spiricom/Genera_Experimenter/README.md

# Vocodec repository
Repository of code for the Snyderphonics Vocodec vocal processor unit.
requires LEAF as a submodule.
