spiricom/Genera_Experimenter/kicad_files/H7Experimenternew/STM32H7_experimenter/Genera_Experimenter_rev1_README.rtf

README.txt for Genera_Experimenter_rev1

Designer : Jeff Snyder

4-layer PCB
1oz copper
matte black soldermask
2.4625" X 3.3750" board size
Not ITAR controlled

smallest drill 10 mils
smallest trace 8 mils
smallest space 8 mils
silkscreen on top and bottom

file extensions:
.cmp = top copper
.ly2 = layer 2 copper
.ly3 = layer 3 copper
.sol = bottom copper
.stc = stopmask top
.sts = stopmask bottom
.plc = silkscreen top
.pls = silkscreen bottom
.drd = excellon drill file
.mil = outline milling
.crc = solder paste top
.crs = solder paste bottom
