spiricom/Genera_Experimenter/kicad_files/H7Experimenternew/stm32H7_experimenter10.brd

## EAGLE design kicad_files/H7Experimenternew/stm32H7_experimenter10.brd (2026-07-16)

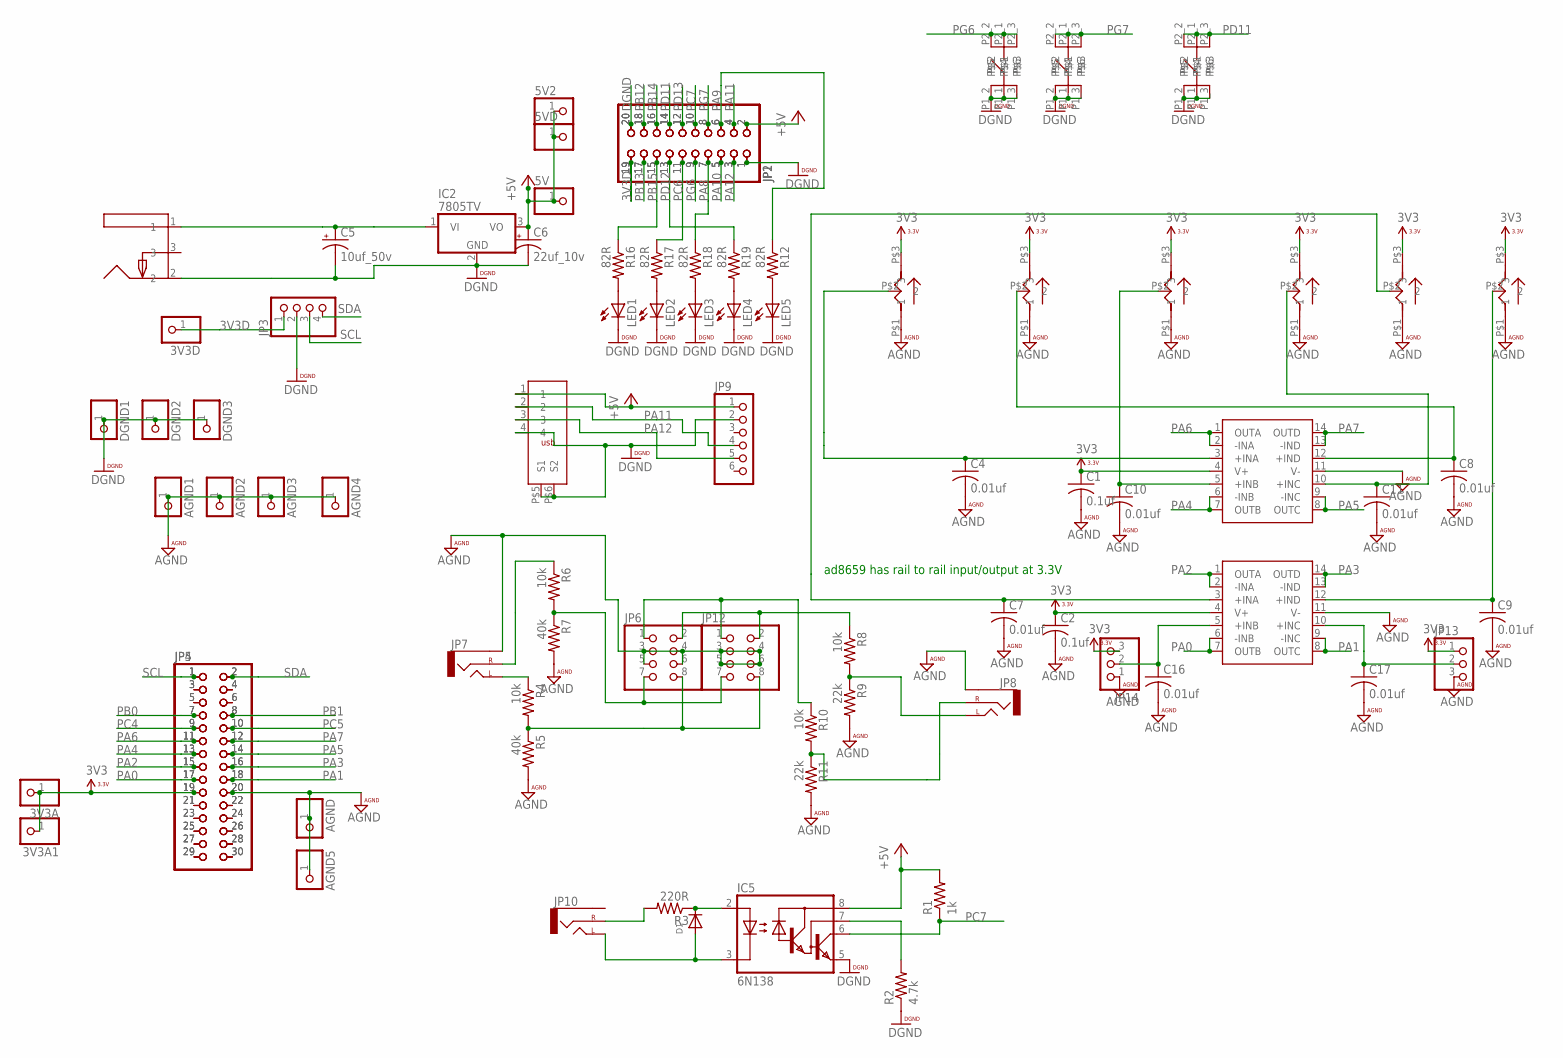
[picture p4: schematic stm32H7_experimenter10.sch]

Parts:
3V3A, 3V3A1, 3V3D, 5V, 5V2, 5VD: PINHD-1X1; 1X01; PARTNO *DNP
AGND, AGND1, AGND2, AGND3, AGND4, AGND5: PINHD-1X1; 1X01; PARTNO *DNP
C1, C2: 0.1uf; C025-030X050; PARTNO K104K15X7RF5TL2
C4, C7, C8, C9, C10, C11, C16, C17: 0.01uf; C025-030X050; PARTNO K103K15X7RF5TL2
C5: 10uf_50v; SMC_C; PARTNO 293D106X9035C2TE3
C6: 22uf_10v; SMC_C; PARTNO T491C226K016AT
D1: DIODEDO-1N4148; DO-1N4148; PARTNO 1N4148
DGND1, DGND2, DGND3: PINHD-1X1; 1X01; PARTNO *DNP
IC1, IC3: AD8659; SO14; PARTNO AD8659ARZ-R7
IC2: 7805TV; TO220V; PARTNO VX7805-1000
IC5: 6N138; DIL08; PARTNO 6N138
JP1: PINHD-2X10; 2X10; PARTNO *DNP
JP2: PINHD-2X10; 2X10; PARTNO 67996-120HLF
JP3: PINHD-1X4; 1X04; PARTNO *DNP
JP4: PINHD-2X15; 2X15; PARTNO 67996-130HLF
JP5: PINHD-2X15; 2X15; PARTNO *DNP
JP6: PINHD-2X4; 2X04; PARTNO 67996-108HLF
JP7, JP8, JP10: AUDIO-JACKPTH; AUDIO-JACK; PARTNO SJ1-3525N
JP9: PINHD-1X6; 1X06
JP12: PINHD-2X4; 2X04; PARTNO *DNP
JP13, JP14: PINHD-1X3; 1X03; PARTNO *DNP
LED1, LED2, LED3, LED4, LED5: LED3MM; PARTNO 151031SS04000
P1, P2, P3, P4, P5, P6: RK09SONGHUEI; R0904N; PARTNO *
R1: 1k; 0204/5; PARTNO RNMF14FTC1K00
R2: 4.7k; 0204/5; PARTNO RNMF14FTC4K70
R3: 220R; 0204/5; PARTNO RNMF14FTC220R
R4, R6, R8, R10: 10k; 0204/5; PARTNO RNMF14FTC10K0
R5, R7: 40k; 0204/5; PARTNO RNMF14FTC39K0
R9, R11: 22k; 0204/5; PARTNO RNMF14FTC22K0
R12, R18, R19: 82R; 0204/5; PARTNO RNMF14FTC82R0
R16, R17: 82R; 0204V; PARTNO RNMF14FTC82R0
S1, S2, S3: TL52_PLUS; PARTNO TL52AF160Q
U$1: PJ-058AH_PWR_JACK; PJ-058AH
U$3: USB_292303-1; 292303

Connections:
3V3A: 3V3A.1, 3V3A1.1, C1.1, C2.1, IC1.4 (V+), IC3.4 (V+), JP4.19, JP5.19, JP13.1, JP14.3, P1.P$3 (3), P2.P$3 (3), P3.P$3 (3), P4.P$3 (3), P5.P$3 (3), P6.P$3 (3)
3V3D: 3V3D.1, JP1.19, JP2.19, JP3.1
+5V: 5V.1, 5V2.1, 5VD.1, C6.+, IC2.3 (VO), IC5.8 (VCC), JP1.2, JP2.2, JP9.1, R1.2, U$3.1
AGND: AGND.1, AGND1.1, AGND2.1, AGND3.1, AGND4.1, AGND5.1, C1.2, C2.2, C4.2, C7.2, C8.2, C9.2, C10.2, C11.2, C16.2, C17.2, IC1.11 (V-), IC3.11 (V-), JP4.20, JP5.20, JP6.3, JP6.4, JP6.5, JP6.6, JP7.SLEEVE, JP8.SLEEVE, JP12.3, JP12.4, JP12.5, JP12.6, JP13.3, JP14.1, P1.P$1 (1), P2.P$1 (1), P3.P$1 (1), P4.P$1 (1), P5.P$1 (1), P6.P$1 (1), R5.2, R7.2, R9.2, R11.2
DGND: C5.-, C6.-, DGND1.1, DGND2.1, DGND3.1, IC2.2 (GND), IC5.5 (GND), JP1.1, JP1.20, JP2.1, JP2.20, JP3.2, JP9.2, LED1.K (C), LED2.K (C), LED3.K (C), LED4.K (C), LED5.K (C), R2.1, S1.P1_1, S1.P1_2, S1.P1_3, S2.P1_1, S2.P1_2, S2.P1_3, S3.P1_1, S3.P1_2, S3.P1_3, U$1.2, U$3.4, U$3.P$5 (S1), U$3.P$6 (S2)
unnamed: D1.A, IC5.3 (C), JP10.TIP (LEFT)
unnamed: D1.C, IC5.2 (A), R3.1
unnamed: IC5.7 (VB), R2.2
unnamed: JP10.RING (RIGHT), R3.2
unnamed: C4.1, IC1.3 (+INA), P1.P$2 (2)
unnamed: C8.1, IC1.12 (+IND), P2.P$2 (2)
unnamed: C10.1, IC1.5 (+INB), P3.P$2 (2)
unnamed: C11.1, IC1.10 (+INC), P4.P$2 (2)
unnamed: JP4.3, JP5.3
unnamed: JP4.4, JP5.4
unnamed: JP4.5, JP5.5
unnamed: JP4.6, JP5.6
unnamed: C7.1, IC3.3 (+INA), P5.P$2 (2)
unnamed: C9.1, IC3.12 (+IND), P6.P$2 (2)
unnamed: JP4.21, JP5.21
unnamed: JP4.22, JP5.22
unnamed: C5.+, IC2.1 (VI), U$1.1
unnamed: C16.1, IC3.5 (+INB), JP14.2
unnamed: JP6.8, JP12.8, R4.2, R5.1
unnamed: JP6.7, JP12.7, R6.2, R7.1
unnamed: LED5.A, R12.2
unnamed: JP7.TIP (LEFT), R4.1
unnamed: JP8.TIP (LEFT), R8.2, R9.1
unnamed: C17.1, IC3.10 (+INC), JP13.2
unnamed: JP7.RING (RIGHT), R6.1
unnamed: JP6.2, JP12.2, R8.1
unnamed: JP8.RING (RIGHT), R10.2, R11.1
unnamed: JP6.1, JP12.1, R10.1
unnamed: LED1.A, R16.2
unnamed: LED2.A, R17.2
unnamed: LED3.A, R18.2
unnamed: LED4.A, R19.2
unnamed: JP4.23, JP5.23
unnamed: JP4.24, JP5.24
unnamed: JP4.25, JP5.25
unnamed: JP4.26, JP5.26
unnamed: JP4.27, JP5.27
unnamed: JP4.28, JP5.28
unnamed: JP4.29, JP5.29
unnamed: JP4.30, JP5.30
PA0: IC3.6 (-INB), IC3.7 (OUTB), JP4.17, JP5.17
PA1: IC3.8 (OUTC), IC3.9 (-INC), JP4.18, JP5.18
PA2: IC3.1 (OUTA), IC3.2 (-INA), JP4.15, JP5.15
PA3: IC3.13 (-IND), IC3.14 (OUTD), JP4.16, JP5.16
PA4: IC1.6 (-INB), IC1.7 (OUTB), JP4.13, JP5.13
PA5: IC1.8 (OUTC), IC1.9 (-INC), JP4.14, JP5.14
PA6: IC1.1 (OUTA), IC1.2 (-INA), JP4.11, JP5.11
PA7: IC1.13 (-IND), IC1.14 (OUTD), JP4.12, JP5.12
PA8: JP1.7, JP2.7, R18.1
PA9: JP1.6, JP2.6, R12.1
PA10: JP1.5, JP2.5
PA11: JP1.4, JP2.4, JP9.4, U$3.2
PA12: JP1.3, JP2.3, JP9.5, U$3.3
PB0: JP4.7, JP5.7
PB1: JP4.8, JP5.8
PB12: JP1.18, JP2.18
PB13: JP1.17, JP2.17
PB14: JP1.16, JP2.16
PB15: JP1.15, JP2.15, R16.1
PC4: JP4.9, JP5.9
PC5: JP4.10, JP5.10
PC6: JP1.11, JP2.11, R17.1
PC7: IC5.6 (VO), JP1.10, JP2.10, R1.1
PD11: JP1.14, JP2.14, S3.P2_1, S3.P2_2, S3.P2_3
PD12: JP1.13, JP2.13, R19.1
PD13: JP1.12, JP2.12
PG6: JP1.9, JP2.9, S1.P2_1, S1.P2_2, S1.P2_3
PG7: JP1.8, JP2.8, S2.P2_1, S2.P2_2, S2.P2_3
SCL: JP3.3, JP4.1, JP5.1
SDA: JP3.4, JP4.2, JP5.2

Notes on the sheet:
ad8659 has rail to rail input/output at 3.3V

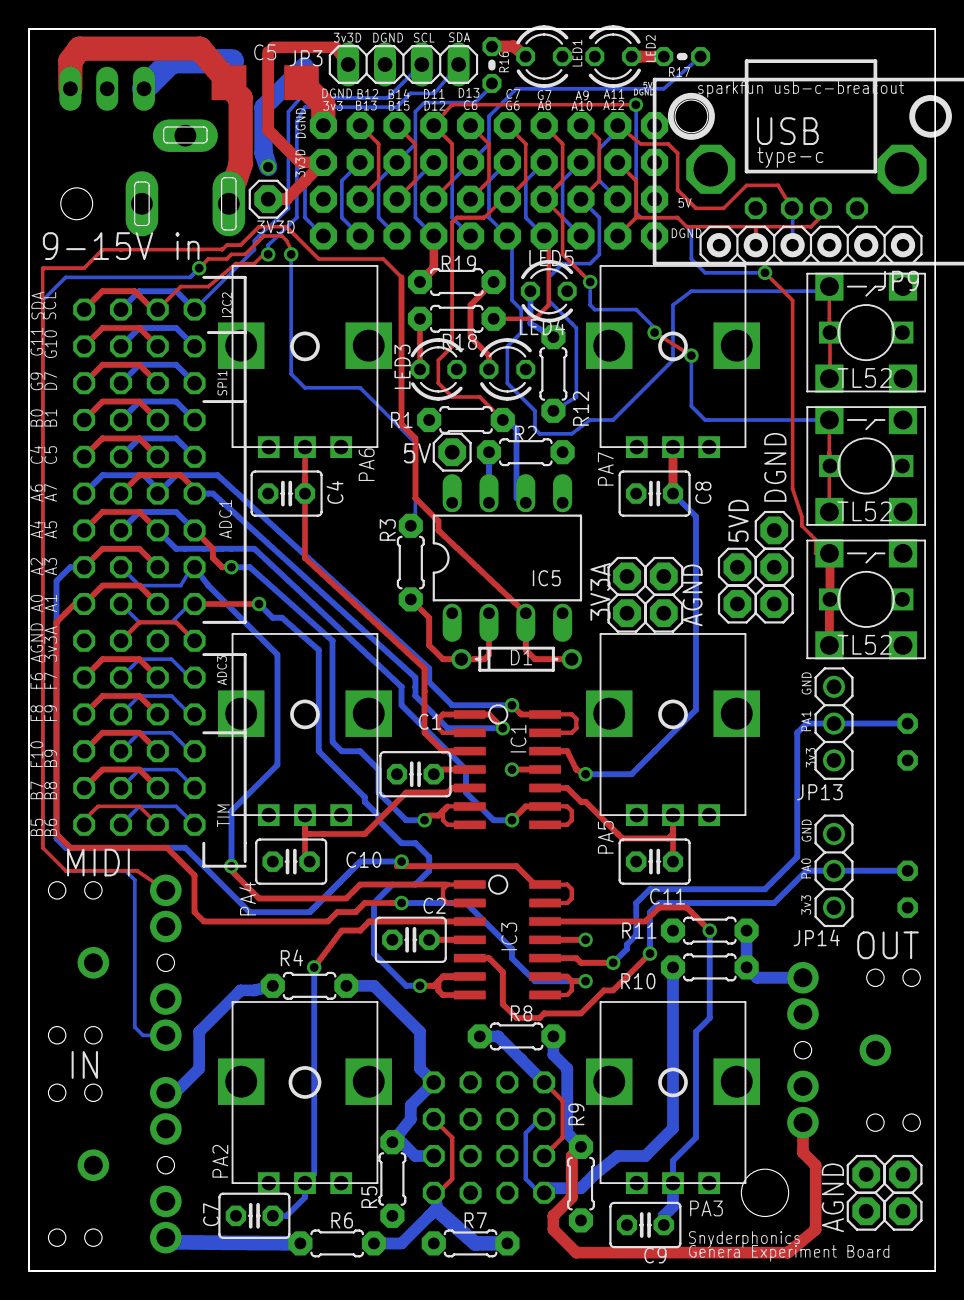
[picture p5: board stm32H7_experimenter10.brd from above]

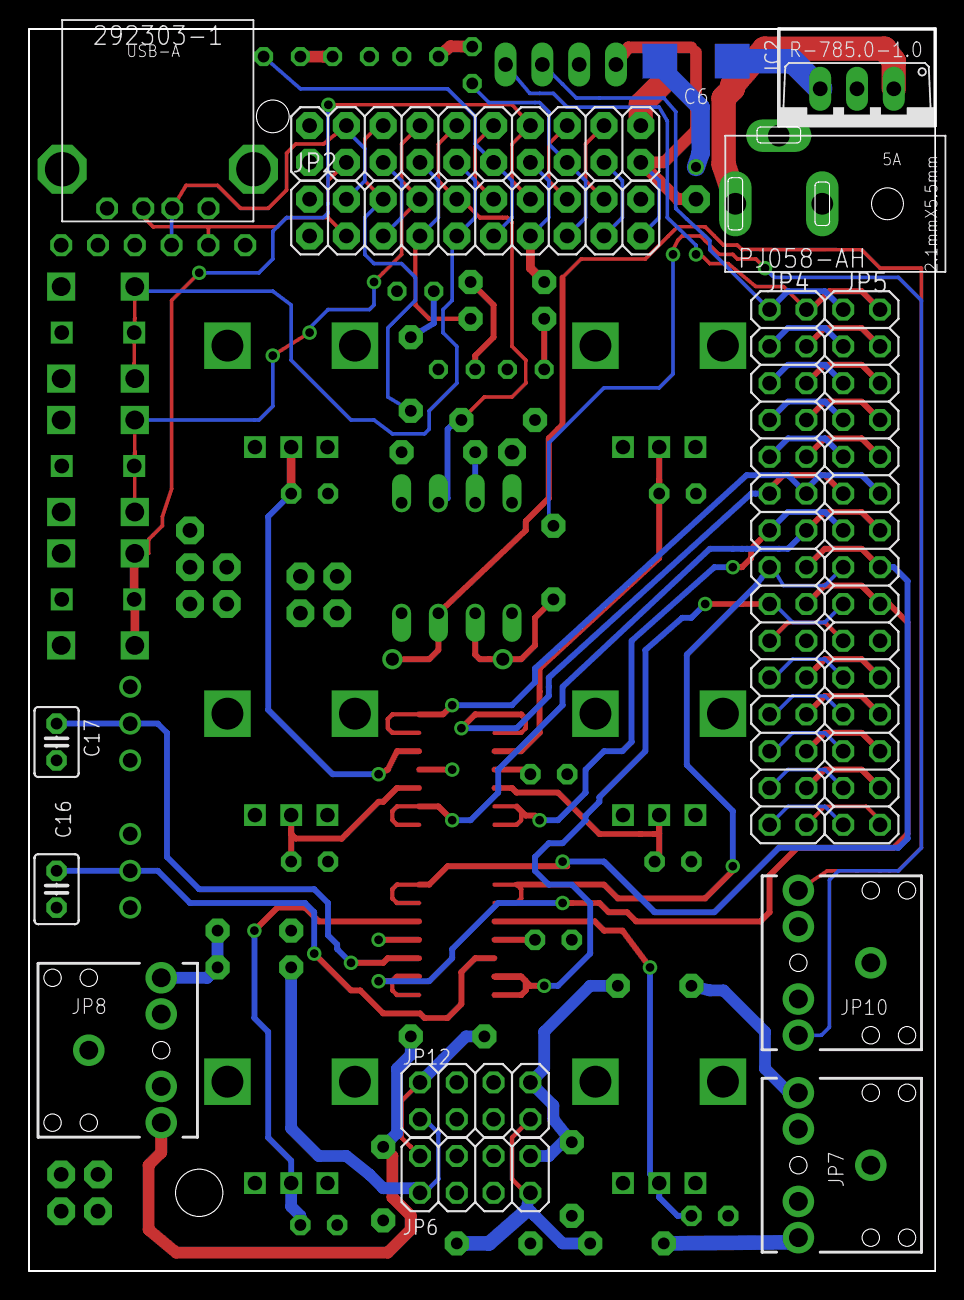
[picture p6: board stm32H7_experimenter10.brd from below]

Board: 6 copper layers, 62.5 x 85.7 mm, 77 parts (15 on the bottom side), 75 nets.
