spiricom/Genera_Experimenter/leaf/Src/leaf-reverb.c

/*==============================================================================

    leaf-reverb.c
    Created: 20 Jan 2017 12:02:04pm
    Author:  Michael R Mulshine

==============================================================================*/

#if _WIN32 || _WIN64

#include "..\Inc\leaf-reverb.h"
#include "..\leaf.h"

#else

#include "../Inc/leaf-reverb.h"
#include "../leaf.h"

#endif

// ~ ~ ~ ~ ~ ~ ~ ~ ~ ~ ~ ~ ~ ~ PRCReverb ~ ~ ~ ~ ~ ~ ~ ~ ~ ~ ~ ~ ~ ~ ~ //
void    tPRCReverb_init(tPRCReverb* const rev, Lfloat t60, LEAF* const leaf)
{
    tPRCReverb_initToPool(rev, t60, &leaf->mempool);
}

void    tPRCReverb_initToPool   (tPRCReverb* const rev, Lfloat t60, tMempool* const mp)
{
    _tMempool* m = *mp;
    _tPRCReverb* r = *rev = (_tPRCReverb*) mpool_alloc(sizeof(_tPRCReverb), m);
    r->mempool = m;
    LEAF* leaf = r->mempool->leaf;
    
    if (t60 <= 0.0f) t60 = 0.001f;
    
    r->sampleRate = leaf->sampleRate;
    r->invSampleRate = leaf->invSampleRate;
    
    int lengths[4] = { 341, 613, 1557, 2137 }; // Delay lengths for 44100 Hz sample rate.
    double scaler = r->sampleRate * INV_44100;
    
    int delay, i;
    if (scaler != 1.0f)
    {
        for (i=0; i<4; i++)
        {
            delay = (int) scaler * lengths[i];
            
            if ( (delay & 1) == 0)          delay++;
            
            while ( !LEAF_isPrime(delay) )  delay += 2;
            
            lengths[i] = delay;
        }
    }
    
    tDelay_initToPool(&r->allpassDelays[0], lengths[0], lengths[0] * 2, mp);
    tDelay_initToPool(&r->allpassDelays[1], lengths[1], lengths[1] * 2, mp);
    tDelay_initToPool(&r->combDelay, lengths[2], lengths[2] * 2, mp);
    
    tPRCReverb_setT60(*rev, t60);
    
    r->allpassCoeff = 0.7f;
    r->mix = 0.5f;
}

void    tPRCReverb_free (tPRCReverb* const rev)
{
    _tPRCReverb* r = *rev;
    
    tDelay_free(&r->allpassDelays[0]);
    tDelay_free(&r->allpassDelays[1]);
    tDelay_free(&r->combDelay);
    mpool_free((char*)r, r->mempool);
}

void    tPRCRevert_clear(tPRCReverb const r)
{
    tDelay_clear(r->allpassDelays[0]);
    tDelay_clear(r->allpassDelays[1]);
    tDelay_clear(r->combDelay);
}

void    tPRCReverb_setT60(tPRCReverb const r, Lfloat t60)
{
    if ( t60 <= 0.0f ) t60 = 0.001f;
    
    r->t60 = t60;
    
    r->combCoeff = powf(10.0f, (-3.0f * tDelay_getDelay(r->combDelay) * r->invSampleRate / t60 ));
}

void    tPRCReverb_setMix(tPRCReverb const r, Lfloat mix)
{
    r->mix = mix;
}

Lfloat   tPRCReverb_tick(tPRCReverb const r, Lfloat input)
{
    Lfloat temp, temp0, temp1, temp2;
    Lfloat out;
    
    r->lastIn = input;
    
    temp = tDelay_getLastOut(r->allpassDelays[0]);
    temp0 = r->allpassCoeff * temp;
    temp0 += input;
    tDelay_tick(r->allpassDelays[0], temp0);
    temp0 = -( r->allpassCoeff * temp0) + temp;
    
    temp = tDelay_getLastOut(r->allpassDelays[1]);
    temp1 = r->allpassCoeff * temp;
    temp1 += temp0;
    tDelay_tick(r->allpassDelays[1], temp1);
    temp1 = -(r->allpassCoeff * temp1) + temp;
    
    temp2 = temp1 + ( r->combCoeff * tDelay_getLastOut(r->combDelay));
    
    out = r->mix * tDelay_tick(r->combDelay, temp2);
    
    temp = (1.0f - r->mix) * input;
    
    out += temp;
    
    r->lastOut = out;
    
    return out;
}

void     tPRCReverb_setSampleRate (tPRCReverb const r, Lfloat sr)
{
    r->sampleRate = sr;
    r->invSampleRate = 1.0f/r->sampleRate;
    
    int lengths[4] = { 341, 613, 1557, 2137 }; // Delay lengths for 44100 Hz sample rate.
    double scaler = r->sampleRate * INV_44100;
    
    int delay, i;
    if (scaler != 1.0f)
    {
        for (i=0; i<4; i++)
        {
            delay = (int) scaler * lengths[i];
            
            if ( (delay & 1) == 0)          delay++;
            
            while ( !LEAF_isPrime(delay) )  delay += 2;
            
            lengths[i] = delay;
        }
    }
    
    tDelay_free(&r->allpassDelays[0]);
    tDelay_free(&r->allpassDelays[1]);
    tDelay_free(&r->combDelay);
    
    tDelay_initToPool(&r->allpassDelays[0], lengths[0], lengths[0] * 2, &r->mempool);
    tDelay_initToPool(&r->allpassDelays[1], lengths[1], lengths[1] * 2, &r->mempool);
    tDelay_initToPool(&r->combDelay, lengths[2], lengths[2] * 2, &r->mempool);
    
    r->combCoeff = powf(10.0f, (-3.0f * tDelay_getDelay(r->combDelay) * r->invSampleRate / r->t60 ));
}

/* ~ ~ ~ ~ ~ ~ ~ ~ ~ ~ ~ ~ ~ ~ ~ ~ ~ ~ NReverb ~ ~ ~ ~ ~ ~ ~ ~ ~ ~ ~ ~ ~ ~ ~ ~ ~ ~ ~ ~ ~ */
void    tNReverb_init(tNReverb* const rev, Lfloat t60, LEAF* const leaf)
{
    tNReverb_initToPool(rev, t60, &leaf->mempool);
}

void    tNReverb_initToPool     (tNReverb* const rev, Lfloat t60, tMempool* const mp)
{
    _tMempool* m = *mp;
    _tNReverb* r = *rev = (_tNReverb*) mpool_alloc(sizeof(_tNReverb), m);
    r->mempool = m;
    LEAF* leaf = r->mempool->leaf;
    
    if (t60 <= 0.0f) t60 = 0.001f;
    
    r->sampleRate = leaf->sampleRate;
    r->invSampleRate = leaf->invSampleRate;
    
    int lengths[15] = {1433, 1601, 1867, 2053, 2251, 2399, 347, 113, 37, 59, 53, 43, 37, 29, 19}; // Delay lengths for 44100 Hz sample rate.
    double scaler = r->sampleRate * INV_44100;// / 25641.0f;
    
    int delay, i;
    
    for (i=0; i < 15; i++)
    {
        delay = (int) scaler * lengths[i];
        if ( (delay & 1) == 0)
            delay++;
        while ( !LEAF_isPrime(delay) )
            delay += 2;
        lengths[i] = delay;
    }
    
    for ( i=0; i<6; i++ )
    {
        tLinearDelay_initToPool(&r->combDelays[i], lengths[i], lengths[i] * 2, mp);
        tLinearDelay_clear(r->combDelays[i]);
        r->combCoeffs[i] = powf(10.0f, (-3.0f * (Lfloat)lengths[i] * r->invSampleRate / t60));
    }
    
    for ( i=0; i<8; i++ )
    {
        tLinearDelay_initToPool(&r->allpassDelays[i], lengths[i+6], lengths[i+6] * 2, mp);
        tLinearDelay_clear(r->allpassDelays[i]);
    }
    
    tNReverb_setT60(r, t60);
    r->allpassCoeff = 0.7f;
    r->mix = 0.3f;
}

void    tNReverb_free (tNReverb* const rev)
{
    _tNReverb* r = *rev;
    
    for (int i = 0; i < 6; i++)
    {
        tLinearDelay_free(&r->combDelays[i]);
    }
    
    for (int i = 0; i < 8; i++)
    {
        tLinearDelay_free(&r->allpassDelays[i]);
    }
    
    mpool_free((char*)r, r->mempool);
}

void    tNReverb_setT60(tNReverb const r, Lfloat t60)
{
    if (t60 <= 0.0f) t60 = 0.001f;
    
    r->t60 = t60;
    
    for (int i=0; i<6; i++) r->combCoeffs[i] = powf(10.0f, (-3.0f * tLinearDelay_getDelay(r->combDelays[i]) * r->invSampleRate / t60 ));
}

void    tNReverb_setMix(tNReverb const r, Lfloat mix)
{
    r->mix = mix;
}

void    tNReverb_clear             (tNReverb const r)
{
    for (int i = 0; i < 6; i++)
    {
        tLinearDelay_clear(r->combDelays[i]);
    }
    
    for (int i = 0; i < 8; i++)
    {
        tLinearDelay_clear(r->allpassDelays[i]);
    }
}
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
