spiricom/Genera_Experimenter/(commit log)

2020-03-07 fixed issues with build and broken sw4stm config file
    [cube_for_new_genera_brain4 Debug.cfg]
2020-03-07 fixed linker file to allow for SDRAM access
    [cube_for_new_genera_brain4.ioc, main.c]
2020-03-21 added SPI
2020-03-22 removed unnecessary HAL peripherals, added string fret measurements roughly
    [cube_for_new_genera_brain4 Run.cfg]
2020-07-09 edited lots of things, somewht working pluck detection in adc callback, simple monophonic handling
2020-07-10 decent attack detection, currently trying to work on logging to SD card
2020-07-27 code to record full sensor data from the electrobass and store it to an SD card for analysis
2020-08-31 newer version with 2X oversampling of all saturation and no saturation in filters
2020-08-31 adjusted ranges of controls for better filtering
2020-09-01 version of filterbank
2020-09-02 pushing current version
2020-09-06 added code to allow parsing of broadcast wav files, which previously broke it. Still havent figured out how to handle multichannel files on the reading end
    [audiostream.c, audiostream.h, main.c, main.h]
2020-09-06 fixed wave.c to properly read stereo files and read much more quickly by using a large scratch buffer and loading the whole sample data at once rather than tons of tiny sd card reads
    [audiostream.c, audiostream.h, main.c]
2020-09-08 version where the genera takes two triggers in on the audio inputs and sends out two different samples on the output channels
2020-09-10 quite good sample playback happening. Tested using SDMMC IDMA and it was slower because I couldnt use DTCMRAM. Went back to polling. Found tricky bug in the tSampler object that also explains weirdne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
    [audiostream.c, audiostream.h, cube_for_new_genera_brain4.ioc, main.c, main.h, sd_diskio.c]
2020-11-15 current SD card code
2026-04-15 current state
2026-04-15 replaced with Electrosteel audio version
    [Electrosteel_audio Debug.cfg, cube_for_new_genera_brain4 Debug.cfg, cube_for_new_genera_brain4 Run.cfg]
2026-04-15 errors during build but has electrosteel code
    [H7Experimenter.kicad_pcb, H7Experimenter.kicad_sch, Untitled.kicad_pcb, Untitled.kicad_sch, stm32H7_experimenter10.kicad_pcb, stm32H7_experimenter10.kicad_sch]
2026-06-18 added kicad file
2026-07-06 version that can load Electrosynth1 patches from midi or sd card
    [Electrosteel_audio Debug.cfg, Vocodec_rev2_2.brd, Vocodec_rev2_2.sch, Vocodec_rev2_2_BOM.xls, Vocodec_rev2_2_centroid.csv, Vocodec_rev2_2_panelonly.brd, Vocodec_rev2_2_panelonly.sch, Vocodec_rev2_2_panelonly_N.cmp.dxf]
2026-07-16 new kicad
    [stm32H7_board_rev8_144_16.brd, stm32H7_board_rev8_144_16.sch, stm32H7_experimenter10.brd, stm32H7_experimenter10.kicad_pcb, stm32H7_experimenter10.sch, stm32H7_experimenter6_BOM.csv]
2026-07-31 experimenter kicad
    [stm32H7_experimenter10-B_Cu.gbr, stm32H7_experimenter10-B_Mask.gbr, stm32H7_experimenter10-B_Silkscreen.gbr, stm32H7_experimenter10-Edge_Cuts.gbr, stm32H7_experimenter10-F_Cu.gbr, stm32H7_experimenter10-F_Mask.gbr, stm32H7_experimenter10-F_Silkscreen.gbr, stm32H7_experimenter10-In1_Cu.gbr]
