spiricom/Genera_Experimenter/(notices)

Notices in the files:
Inc/bsp_driver_sd.h:
Copyright (c) 2022 STMicroelectronics.
All rights reserved.
This software is licensed under terms that can be found in the LICENSE file
Src/bsp_driver_sd.c:
© Copyright (c) 2020 STMicroelectronics.
This software component is licensed by ST under Ultimate Liberty license
Src/main.c:
© Copyright (c) 2019 STMicroelectronics.
parts and their libraries:
SparkFun-Connectors: Licensing: Creative Commons ShareAlike 4.0 International - https://creativecommons.org/licenses/by-sa/4.0
PatternAgents-Beautify: License : http://creativecommons.org/licenses/by-sa/3.0
(Creative Commons 3.0)
